jark006/CarbonFreeCar/README.md

# CarbonFreeCar
2017年 第五届全国大学生工程训练综合能力竞赛 电控无碳小车 Carbon free car

主控芯片使用SOP-28封装的STC15F2K32S2

主控板集成OLED显示屏接口，能够显示各项数据，方便调试

模块：0.96' OLED屏幕, 模拟信号舵机（控制方向，控制速度），红外测距传感器GP2Y0A21YK0F，电子罗盘HMC5883， 码盘测速

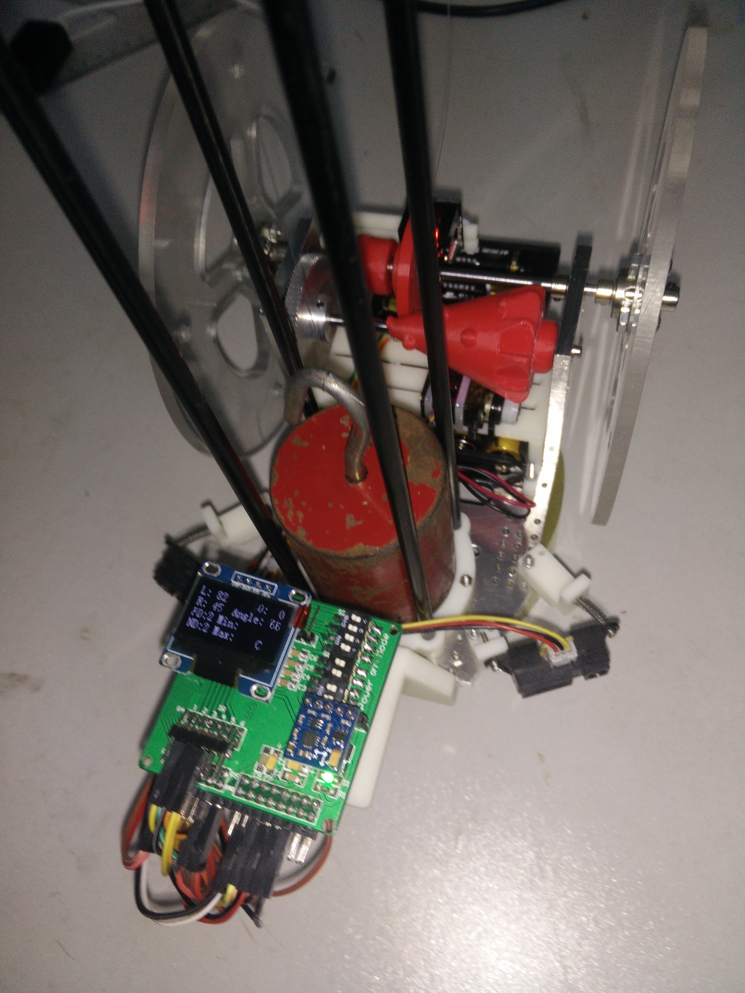
[picture p1: Document/car.jpg]
