jark006/CarbonFreeCar/Document/db8b5caa61d6195b64cf3a662f2e7d3.jpg

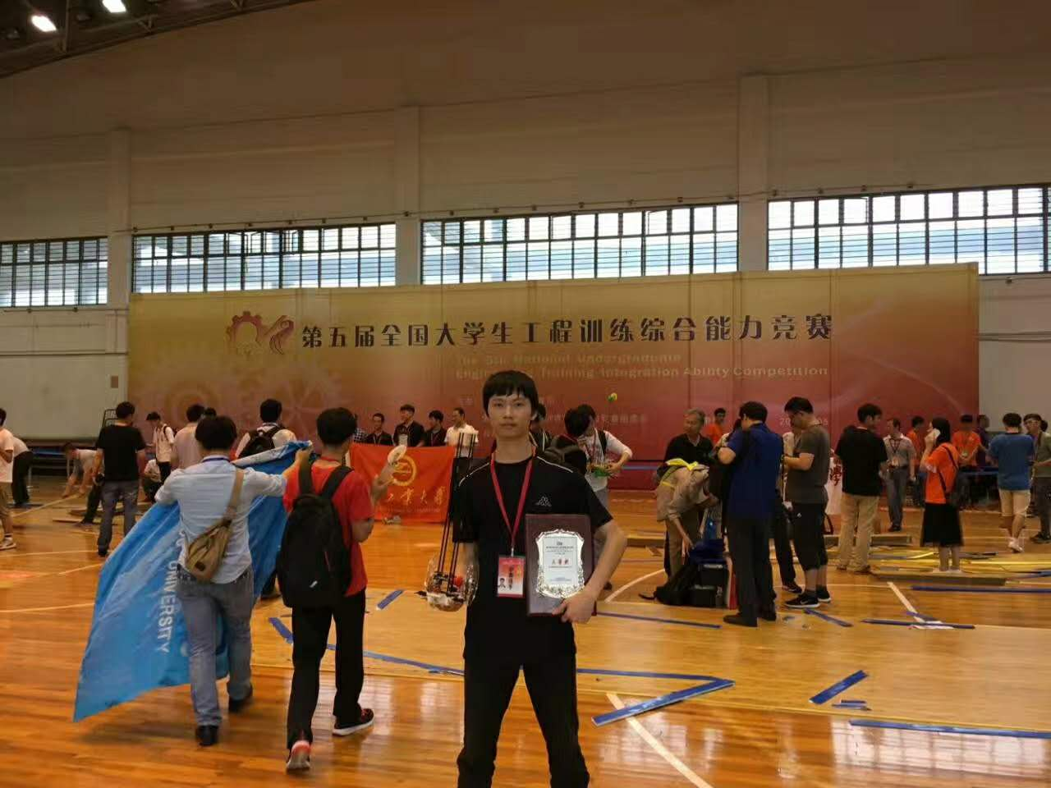
Document/db8b5caa61d6195b64cf3a662f2e7d3.jpg
