jark006/CarbonFreeCar/Document/DIP28.png

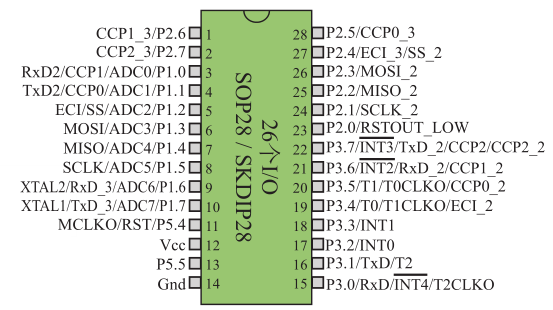
Document/DIP28.png
