jark006/CarbonFreeCar/Document/f1ea1115832ceca1026c7e317d5bd51.jpg

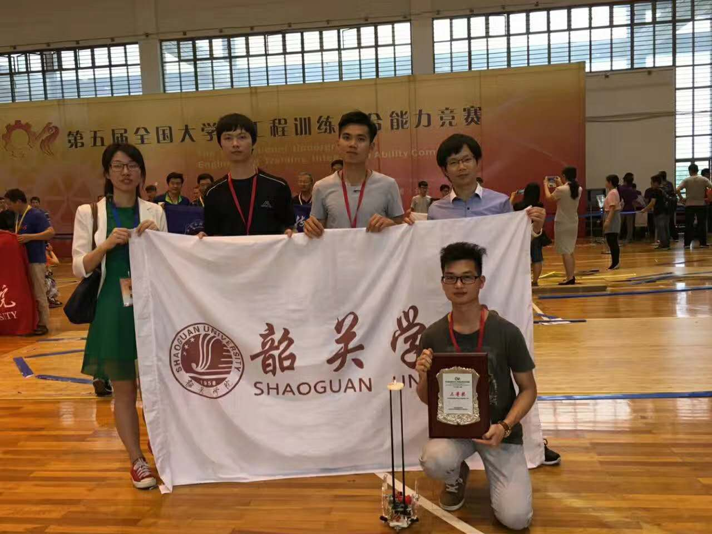
Document/f1ea1115832ceca1026c7e317d5bd51.jpg
