jark006/CarbonFreeCar/Document/IMG_20170319_103259.jpg

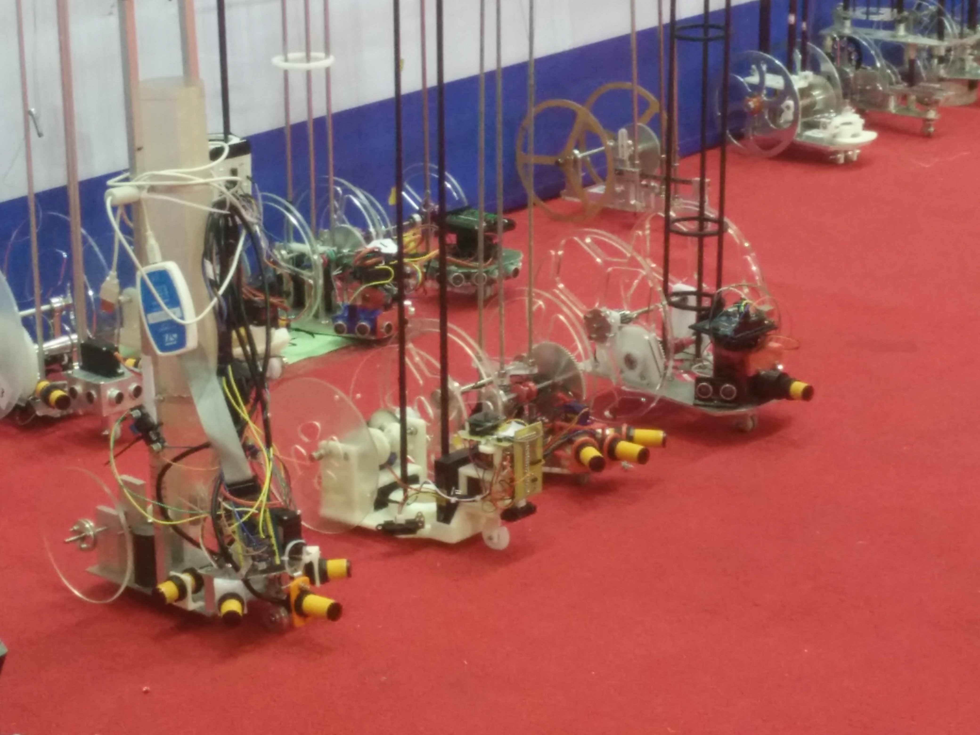
Document/IMG_20170319_103259.jpg
