jark006/CarbonFreeCar/Document/IMG_20170319_104107.jpg

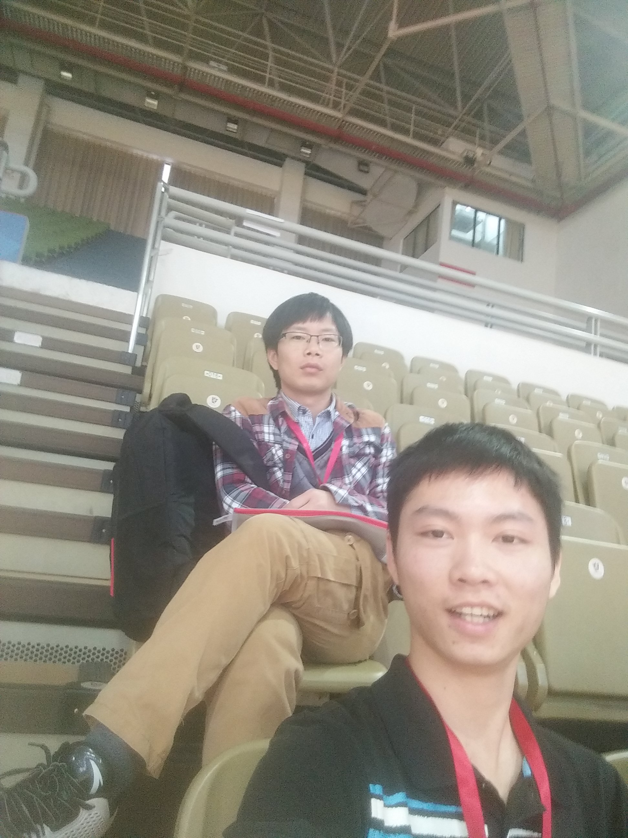
Document/IMG_20170319_104107.jpg
