jark006/CarbonFreeCar/Document/IMG_20170319_104118.jpg

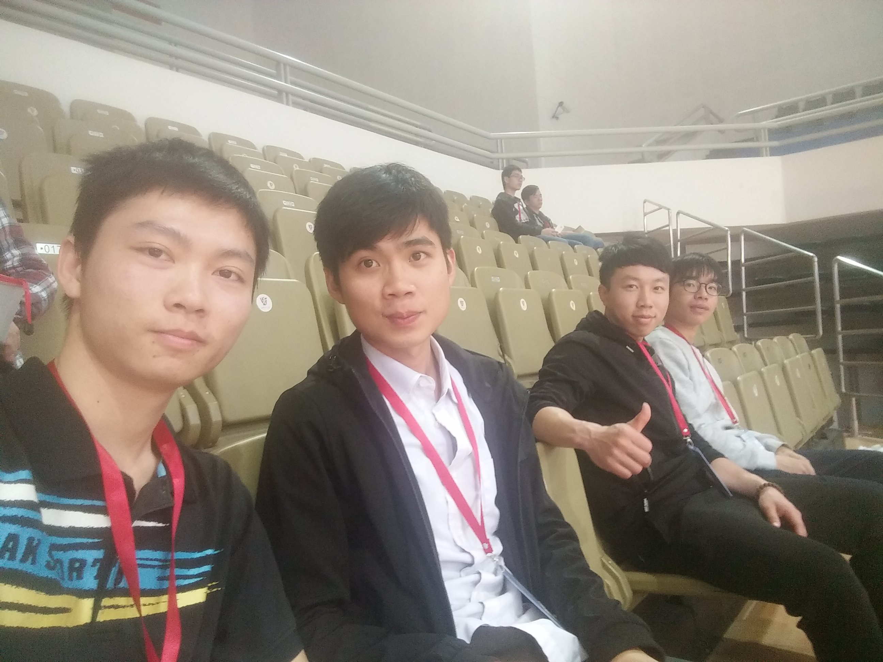
Document/IMG_20170319_104118.jpg
