jark006/CarbonFreeCar/Document/IMG_20170511_211515.jpg

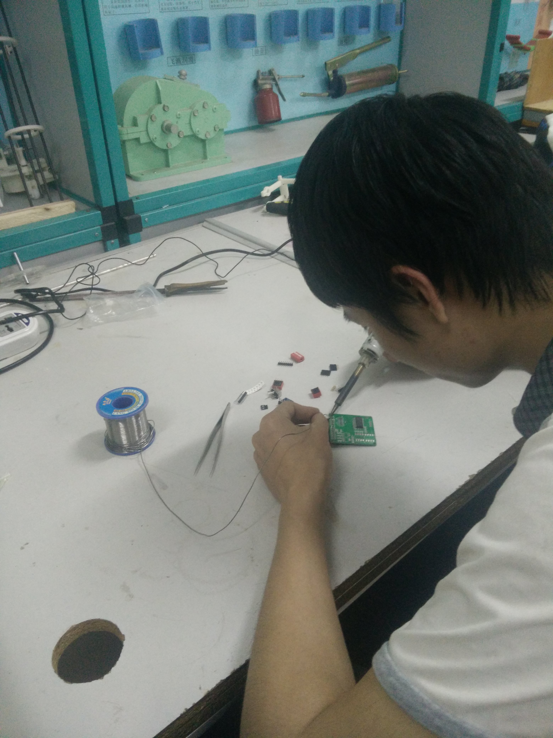
Document/IMG_20170511_211515.jpg
