jark006/CarbonFreeCar/Document/IMG_20170513_080614.jpg

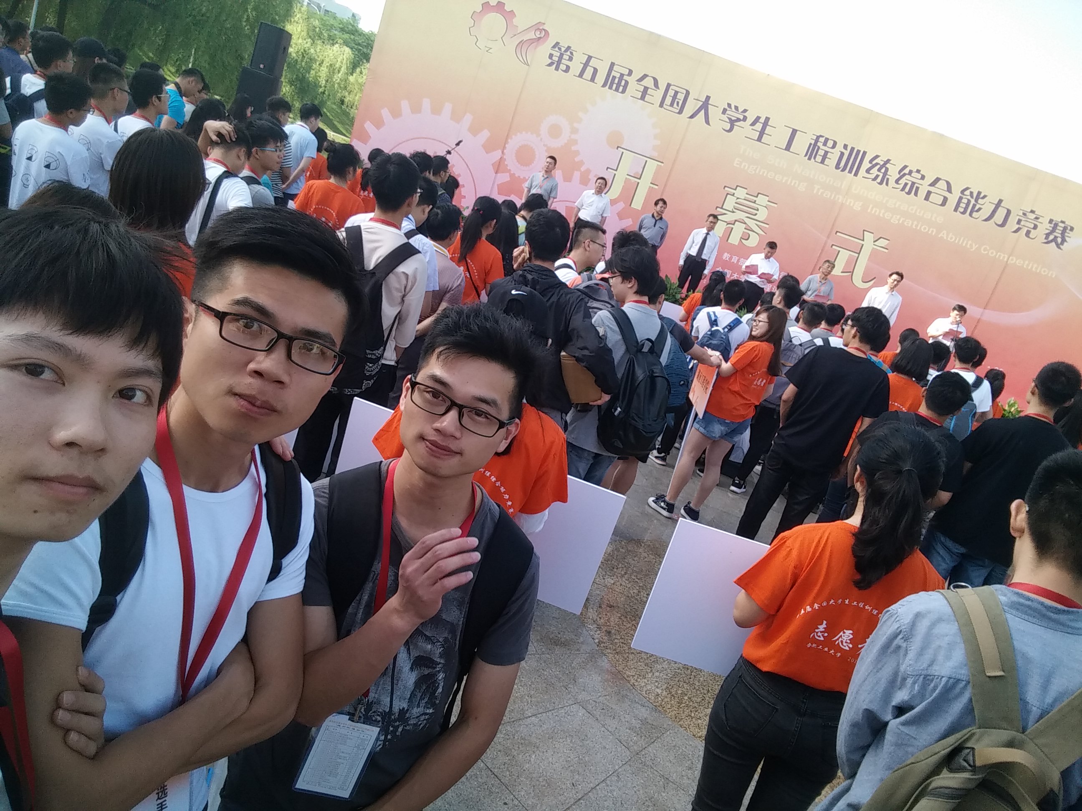
Document/IMG_20170513_080614.jpg
