jark006/CarbonFreeCar/Document/初号机.jpg

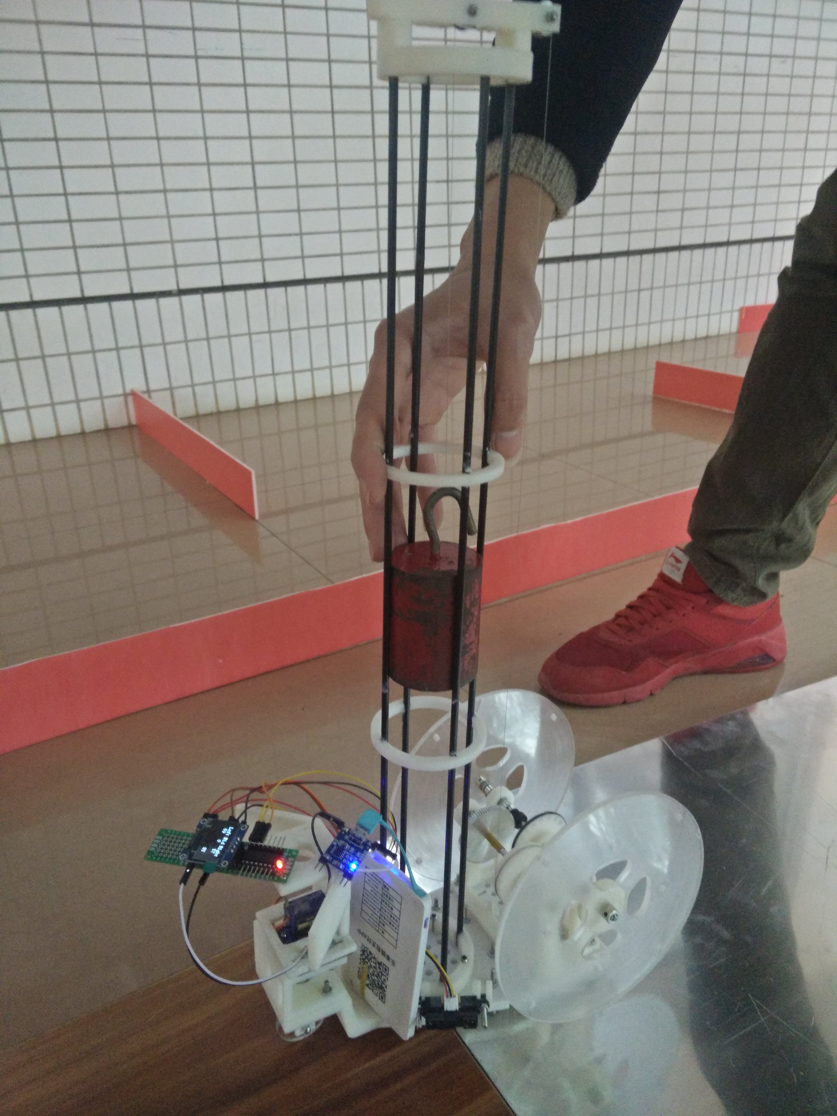
Document/初号机.jpg
