jark006/CarbonFreeCar/Document/省赛版1.jpg

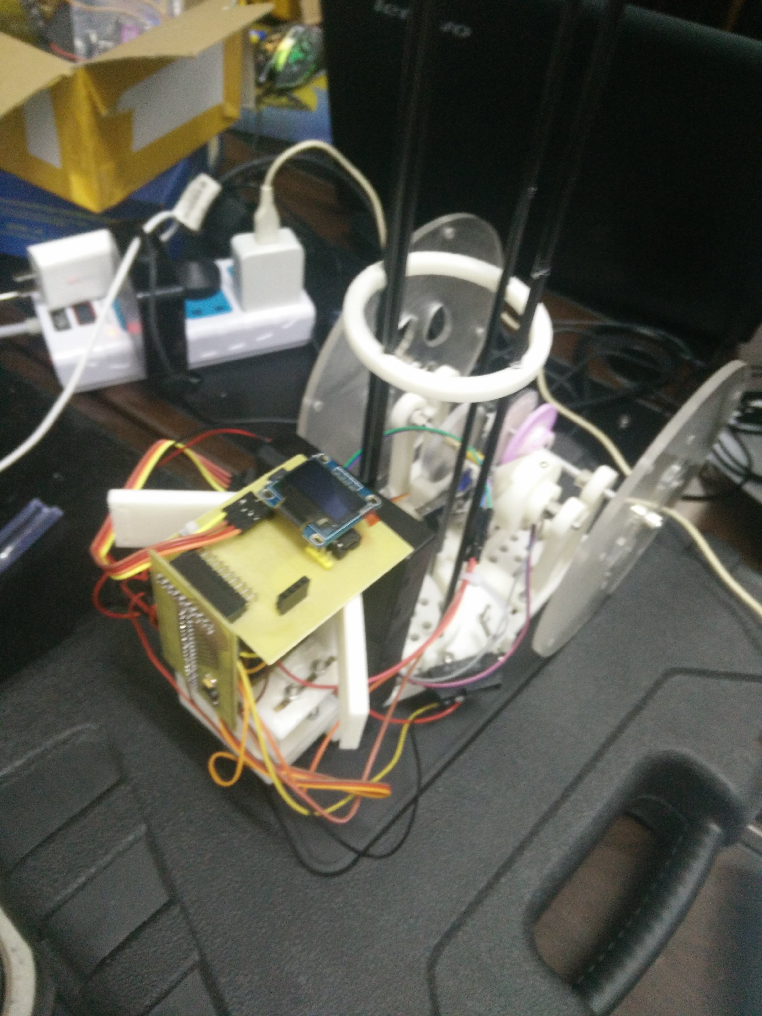
Document/省赛版1.jpg
