jark006/CarbonFreeCar/Document/省赛版2.jpg

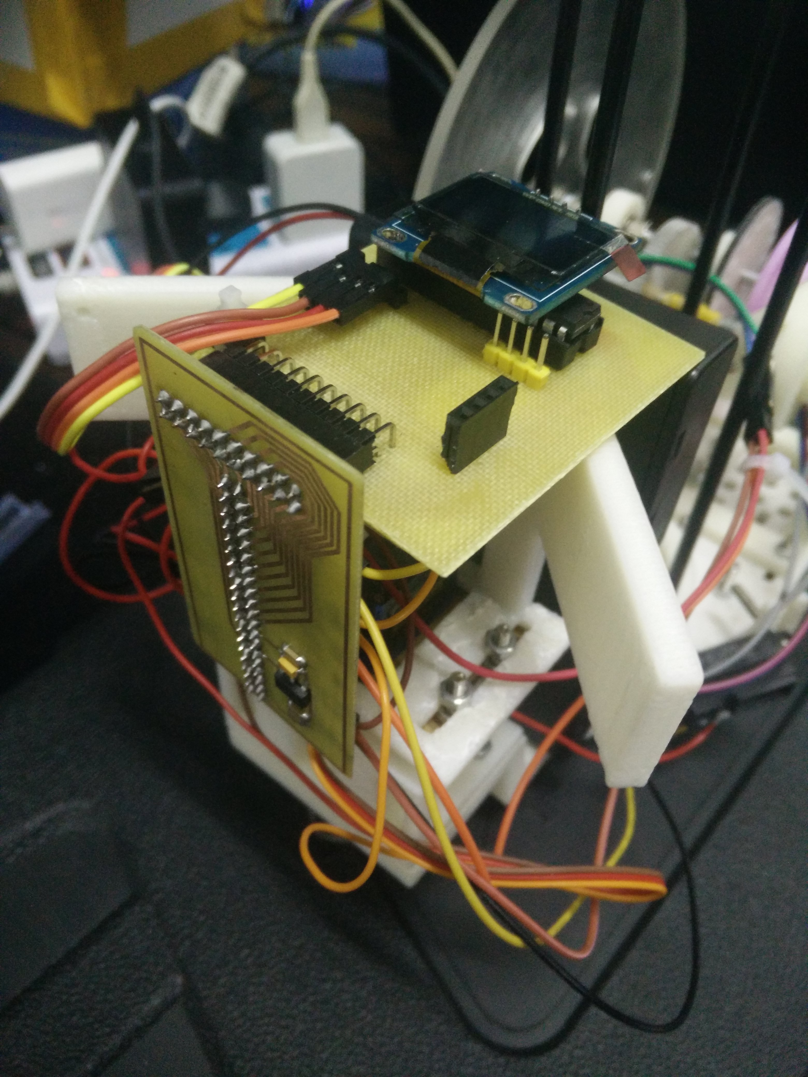
Document/省赛版2.jpg
