jark006/CarbonFreeCar/Document/焊接元件清单.pdf

第五届全国大学生工程训练综合能力竞赛

焊接元件清单

编号 | 名称 | 封装 | 数量
1 | STC15F2K32S | SOP28 | 1
2 | 104（0.1uF）电容 | 1206 | 6
3 | 钽电容 10uF | 1206 | 2
4 | AMS1117-5.0 | SOT-223 | 2
5 | 4 针排母 | X | 2
6 | 插线排针 | X | 3
7 | 4 位拨动开关 | X | 2
8 | 12KΩ电阻 | 1206 | 1
9 | LED 灯 | 0806 | 1
10 | PCB 裸板 | X | 1

韶关学院
