jark006/CarbonFreeCar/(list of files, cad)

Other CAD files:
最终无碳小车电控程序/Objects/Car.obj
最终无碳小车电控程序/Objects/delay.obj
最终无碳小车电控程序/Objects/direction.obj
最终无碳小车电控程序/Objects/distance.obj
最终无碳小车电控程序/Objects/MPU6050.obj
最终无碳小车电控程序/Objects/serial.obj
最终无碳小车电控程序/Objects/HMC5883.obj
