jark006/CarbonFreeCar/src/oled.c

#include "oled.h"

// 0.96寸 OLED
#define WIDTH     128
#define HEIGHT    64

#define SCL P20
#define SDA P21

//ASCII字符集  偏移量32  大小:12*6
/************************************6*8的点阵************************************/
u8 code F6x8[][6] = {
    0x00, 0x00, 0x00, 0x00, 0x00, 0x00,// sp
    0x00, 0x00, 0x00, 0x2f, 0x00, 0x00,// !
    0x00, 0x00, 0x07, 0x00, 0x07, 0x00,// "
    0x00, 0x14, 0x7f, 0x14, 0x7f, 0x14,// #
    0x00, 0x24, 0x2a, 0x7f, 0x2a, 0x12,// $
    0x00, 0x62, 0x64, 0x08, 0x13, 0x23,// %
    0x00, 0x36, 0x49, 0x55, 0x22, 0x50,// &
    0x00, 0x00, 0x05, 0x03, 0x00, 0x00,// '
    0x00, 0x00, 0x1c, 0x22, 0x41, 0x00,// (
    0x00, 0x00, 0x41, 0x22, 0x1c, 0x00,// )
    0x00, 0x14, 0x08, 0x3E, 0x08, 0x14,// *
    0x00, 0x08, 0x08, 0x3E, 0x08, 0x08,// +
    0x00, 0x00, 0x00, 0xA0, 0x60, 0x00,// ,
    0x00, 0x08, 0x08, 0x08, 0x08, 0x08,// -
    0x00, 0x00, 0x60, 0x60, 0x00, 0x00,// .
    0x00, 0x20, 0x10, 0x08, 0x04, 0x02,// /
    0x00, 0x3E, 0x51, 0x49, 0x45, 0x3E,// 0
    0x00, 0x00, 0x42, 0x7F, 0x40, 0x00,// 1
    0x00, 0x42, 0x61, 0x51, 0x49, 0x46,// 2
    0x00, 0x21, 0x41, 0x45, 0x4B, 0x31,// 3
    0x00, 0x18, 0x14, 0x12, 0x7F, 0x10,// 4
    0x00, 0x27, 0x45, 0x45, 0x45, 0x39,// 5
    0x00, 0x3C, 0x4A, 0x49, 0x49, 0x30,// 6
    0x00, 0x01, 0x71, 0x09, 0x05, 0x03,// 7
    0x00, 0x36, 0x49, 0x49, 0x49, 0x36,// 8
    0x00, 0x06, 0x49, 0x49, 0x29, 0x1E,// 9
    0x00, 0x00, 0x36, 0x36, 0x00, 0x00,// :
    0x00, 0x00, 0x56, 0x36, 0x00, 0x00,// ;
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
    0x40,0x40,0x40,0x40,0x40,0x40,0x40,0x00,0x04,0x04,0x04,0x04,0x04,0x04,0x04,0x00,//= 29
    0x00,0x08,0x10,0x20,0x40,0x80,0x00,0x00,0x00,0x20,0x10,0x08,0x04,0x02,0x01,0x00,//> 30
    0x00,0x70,0x48,0x08,0x08,0x08,0xF0,0x00,0x00,0x00,0x00,0x30,0x36,0x01,0x00,0x00,//? 31
    0xC0,0x30,0xC8,0x28,0xE8,0x10,0xE0,0x00,0x07,0x18,0x27,0x24,0x23,0x14,0x0B,0x00,//@ 32
    0x00,0x00,0xC0,0x38,0xE0,0x00,0x00,0x00,0x20,0x3C,0x23,0x02,0x02,0x27,0x38,0x20,//A 33
    0x08,0xF8,0x88,0x88,0x88,0x70,0x00,0x00,0x20,0x3F,0x20,0x20,0x20,0x11,0x0E,0x00,//B 34
    0xC0,0x30,0x08,0x08,0x08,0x08,0x38,0x00,0x07,0x18,0x20,0x20,0x20,0x10,0x08,0x00,//C 35
    0x08,0xF8,0x08,0x08,0x08,0x10,0xE0,0x00,0x20,0x3F,0x20,0x20,0x20,0x10,0x0F,0x00,//D 36
    0x08,0xF8,0x88,0x88,0xE8,0x08,0x10,0x00,0x20,0x3F,0x20,0x20,0x23,0x20,0x18,0x00,//E 37
    0x08,0xF8,0x88,0x88,0xE8,0x08,0x10,0x00,0x20,0x3F,0x20,0x00,0x03,0x00,0x00,0x00,//F 38
    0xC0,0x30,0x08,0x08,0x08,0x38,0x00,0x00,0x07,0x18,0x20,0x20,0x22,0x1E,0x02,0x00,//G 39
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
};

void IIC_Start() {
    SCL = 1;
    SDA = 1;
    SDA = 0;
    SCL = 0;
}

void IIC_Stop() {
    SCL = 0;
    SDA = 0;
    SCL = 1;
    SDA = 1;
}

void Write_IIC_Byte(u8 IIC_Byte) {
    u8 i;
    for (i = 0; i < 8; i++) {
        SDA = IIC_Byte & 0x80;
        SCL = 1;
        SCL = 0;
        IIC_Byte <<= 1;
    }
    SDA = 1;
    SCL = 1;
    SCL = 0;
}

void Write_IIC_Command(u8 IIC_Command) {
    IIC_Start();
    Write_IIC_Byte(0x78);            //Slave address,SA0=0
    Write_IIC_Byte(0x00);            //write command
    Write_IIC_Byte(IIC_Command);
    IIC_Stop();
}

void Write_IIC_Data(u8 IIC_Data) {
    IIC_Start();
    Write_IIC_Byte(0x78);            //D/C#=0; R/W#=0
    Write_IIC_Byte(0x40);            //write data
    Write_IIC_Byte(IIC_Data);
    IIC_Stop();
}

//坐标设置
void OLED_Set_Pos(u8 x, u8 y) {
    Write_IIC_Command(0xb0 + y);
    Write_IIC_Command(((x & 0xf0) >> 4) | 0x10);
    Write_IIC_Command(x & 0x0f);
}

// // 开启OLED显示
// void OLED_Display_On(){
//    Write_IIC_Command(0X8D);  //SET DCDC命令
//    Write_IIC_Command(0X14);  //DCDC ON
//    Write_IIC_Command(0XAF);  //DISPLAY ON
// }

// //关闭OLED显示
// void OLED_Display_Off(){
//    Write_IIC_Command(0X8D);  //SET DCDC命令
//    Write_IIC_Command(0X10);  //DCDC OFF
//    Write_IIC_Command(0XAE);  //DISPLAY OFF
// }

// 清屏函数
void OLED_Clear() {
    u8 i, n;
    for (i = 0; i < 8; i++) {
        Write_IIC_Command(0xb0 + i);  //设置页地址（0~7）
        Write_IIC_Command(0x00);      //设置显示位置—列低地址
        Write_IIC_Command(0x10);      //设置显示位置—列高地址
        for (n = 0; n < WIDTH; n++)
            Write_IIC_Data(0);
    }
}

//在指定位置显示一个字符,包括部分字符
//x:0~127
//y:0~3(12) 0~7(16)
//mode:0,反白显示;1,正常显示
//size:选择字体 16/8
void OLED_ShowChar(u8 x, u8 y, u8 chr, u8 Char_Size) {
    u8 c = 0, i = 0;
    if (Char_Size == 16) y *= 2;
    c = chr - ' ';//得到偏移后的值
    if (x >= HEIGHT) {
        x = 0;
        y = y + 2;
    }
    if (Char_Size == 16) {
        OLED_Set_Pos(x, y);
        for (i = 0; i < 8; i++)
            Write_IIC_Data(F8X16[c * 16 + i]);
        OLED_Set_Pos(x, y + 1);
        for (i = 0; i < 8; i++)
            Write_IIC_Data(F8X16[c * 16 + i + 8]);
    }
    else {
        OLED_Set_Pos(x, y);
        for (i = 0; i < 6; i++)
            Write_IIC_Data(F6x8[c][i]);
    }
}

//m^n函数
u32 oled_pow(u8 m, u8 n) {
    u32 result = 1;
    while (n--)result *= m;
    return result;
}

//显示2个数字
//x,y :起点坐标
//len :数字的位数
//size:字体大小
//mode:模式    0,填充模式;1,叠加模式
//num:数值(0~4294967295);
void OLED_ShowNum(u8 x, u8 y, u32 num, u8 len, u8 size2) {
    u8 t, temp;
    u8 enshow = 0;
    for (t = 0; t < len; t++) {
        temp = (num / oled_pow(10, len - t - 1)) % 10;
        if (enshow == 0 && t < (len - 1)) {
            if (temp == 0) {
                OLED_ShowChar(x + (size2 / 2) * t, y, ' ', size2);
                continue;
            }
            else enshow = 1;
        }
        OLED_ShowChar(x + (size2 / 2) * t, y, temp + '0', size2);
    }
}

/*显示一个字符串
x:该行第几个像素 0~127
y:第几行  0~3
chr:       字符串
Char_Size: 字体大小 8/16
*/
void OLED_ShowString(u8 x, u8 y, u8* chr, u8 Char_Size) {
    u8 j = 0;
    while (chr[j] != '\0') {
        OLED_ShowChar(x, y, chr[j], Char_Size);
        x += 8;
        if (x > 120) {
            x = 0;
            y += 2;
        }
        j++;
    }
}

// 显示一个图片
void Picture(u8* ptr) {
    u8 x, y;
    for (y = 0; y < 8; y++) {
        Write_IIC_Command(0xb0 + y);
        Write_IIC_Command(0x0);
        Write_IIC_Command(0x10);
        for (x = 0; x < WIDTH; x++) {
            Write_IIC_Data(*ptr++);
        }
    }
}

// 初始化 OLED
void Init_OLED(){
    u8 i;
    u8 code cmd[] = {
        0xAE, 0x20, 0x10, 0xb0,
        0xc8, 0x00, 0x10, 0x40,
        0x81, 0xdf, 0xa1, 0xa6,
        0xa8, 0x3F, 0xa4, 0xd3,
        0x00, 0xd5, 0xf0, 0xd9,
        0x22, 0xda, 0x12, 0xdb,
        0x20, 0x8d, 0x14, 0xaf
    };
    for (i = 0; i < sizeof(cmd); i++)
        Write_IIC_Command(cmd[i]);
}
