jark006/CarbonFreeCar/(commit log)

2020-09-09 init project
    [Car.obj, HMC5883.obj, MPU6050.obj, delay.obj, direction.obj, distance.obj, serial.obj]
2025-12-21 整理代码
    [Car.obj, HMC5883.obj, MPU6050.obj, delay.obj, direction.obj, distance.obj, serial.obj]
2025-12-22 整理项目文件
