jark006/CarbonFreeCar/Document/IMG_20171117_120042.jpg

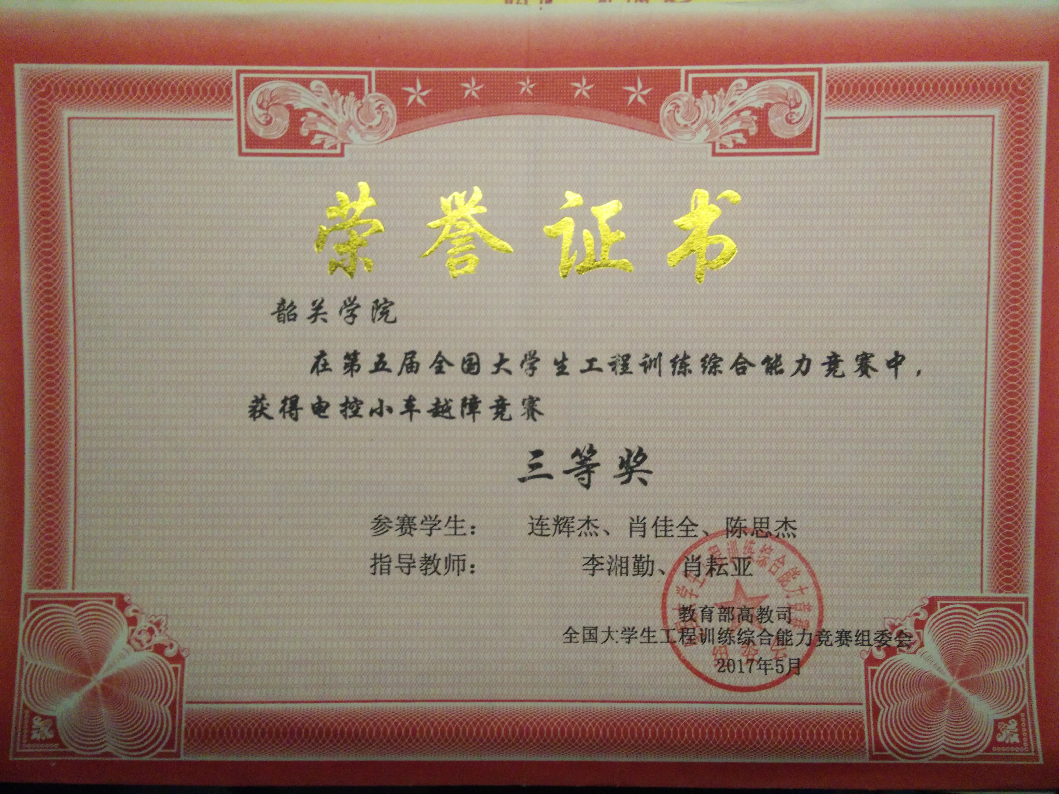
Document/IMG_20171117_120042.jpg
